Ippolz/SiliconSpike/README.md

# Silicon Spike, an Arduino Trigger Box for TMS

## Description
The Arduino Trigger Box project, developed at the Center for Cognitive Neuroscience of Cesena (University of Bologna), offers a reliable and efficient solution for triggering Transcranial Magnetic Stimulation (TMS) and Biopac systems. Designed by Giuseppe Ippolito and Thomas Quettier, this open-source initiative aims to provide the scientific community with a cost-effective and customizable trigger box solution.

## Features
- Easy integration with TMS and Biopac systems.
- Customizable triggering sequences.
- Open-source code for community collaboration and improvement.
- Detailed setup and usage instructions.

## Citing Our Work 
If you use our Arduino Trigger Box in your research, we kindly ask you to acknowledge our work. Please cite the following paper:

Ippolito, G., Quettier, T., Borgomaneri, S., & Romei, V. (2025). Silicon Spike: An Arduino-based low-cost and open-access triggerbox to precisely control TMS devices. _Behavior Research Methods_, _57_(5), 145. https://doi.org/10.3758/s13428-025-02653-y

## License
This project is licensed under the [SPECIFY LICENSE TYPE - e.g., MIT, GPL, Apache, etc.]. For more details, see the `LICENSE.md` file.

## Contact
For inquiries, please contact:
- Thomas Quettier - thomas.quettier2@unibo.it
- Giuseppe Ippolito - giuseppe.ippolito8@unibo.it

## Acknowledgements
We thank the Center for Cognitive Neuroscience, University of Bologna, for supporting this project.

## Collaborative Contributions
We welcome contributions from the community. Please read our `CONTRIBUTING.md` file for guidelines on how to submit improvements or report issues.

For collaborators contributing to this repository, please prefix your commit messages with appropriate tags for efficient tracking and management:
- **BF**: Bug Fix - for resolving errors or issues in existing code.
- **FF**: Feature Fix - for fixes to unreleased code features.
- **RF**: Refactoring - for code structure or design modifications.
- **NF**: New Feature - for introducing new functionalities.
- **ENH**: Enhancement - for improvements to existing features or code.
- **DOC**: Documentation - for updates or additions to project documentation.
- **TEST**: Testing - for adding new tests or modifying existing ones. 

Your cooperation and adherence to these guidelines help maintain the quality and integrity of our project. Thank you for your contributions to the IMPLICIT research initiative.
