Ippolz/SiliconSpike/Codes/Main Code/SiliconSpike_MainCode/SiliconSpike_MainCode.ino

// Triggerbox developed by Giuseppe Ippolito and Thomas Quettier
// Original article here: https://doi.org/10.3758/s13428-025-02653-y

#define MAX_COMMAND_LENGTH 64  // Maximum length of a command

// Pins setting
int LedPin = 3;
int BNC1 = 9, BNC2 = 8, MrkPin = 7;

// Variables setting
int TriggerDuration = 2000;
int IPI1 = 2000, IPI2 = 2000, IPI3 = 2000, IPI4 = 2000, IPI5 = 2000, IPI6 = 2000, IPI7 = 2000, IPI8 = 2000, IPI9 = 2000, IPI10 = 2000;
int nPuls1 = 5, nPuls2 = 5, nPuls3 = 5, nPuls4 = 5, nPuls5 = 5, nPuls6 = 5, nPuls7 = 5, nPuls8 = 5, nPuls9 = 5, nPuls10 = 5;
int MarkerDuration1 = 2000, MarkerDuration2 = 2000, MarkerDuration3 = 2000, MarkerDuration4 = 2000, MarkerDuration5 = 2000, MarkerDuration6 = 2000, MarkerDuration7 = 2000, MarkerDuration8 = 2000, MarkerDuration9 = 2000;
int test = 0, psw = 0;

char inputBuffer[MAX_COMMAND_LENGTH];  // Buffer to store incoming characters
int bufferIndex = 0;                   // Index to track the position in the buffer

void setup() {
  pinMode(LedPin, OUTPUT);  // Debug LED
  pinMode(BNC1, OUTPUT);    // Initialize BNC1 (or CS)
  pinMode(BNC2, OUTPUT);    // Initialize BNC2 (or TS)
  pinMode(MrkPin, OUTPUT);  // Initialize the markers BNC
  Serial.begin(115200);
  Serial.setTimeout(5);  // Set a timeout for the Serial Monitor (for faster code execution)
}


void loop() {
  digitalWrite(LedPin, HIGH);


  while (Serial.available() > 0 && bufferIndex < MAX_COMMAND_LENGTH - 1) {
    char incomingChar = Serial.read();

    // Check for the end of the command
    if (incomingChar == '.') {
      inputBuffer[bufferIndex] = '\0';      // Null-terminate the string
      processCommand(String(inputBuffer));  // Convert to String before calling
      bufferIndex = 0;                      // Reset the buffer index for the next command
    } else {
      inputBuffer[bufferIndex++] = incomingChar;  // Add the character to the buffer
    }
  }

  String command = Serial.readStringUntil('\n');

  if (command.length() > 0) {
    processCommand(command);
  }
}

void processCommand(String command) {

  if (command.equals("Triggerbox developed by Giuseppe Ippolito: https://doi.org/10.3758/s13428-025-02653-y")) {
    psw = 1;
  }
  if (psw == 1) {
    if (command.startsWith("SET,IPI1,")) {
      // Extract the number after "SET,IPI," and convert to integer
      IPI1 = command.substring(9).toInt();
      IPI1 = IPI1 * 1000;
      IPI1 = IPI1 - TriggerDuration;
    } else if (command.startsWith("SET,IPI2,")) {
      IPI2 = command.substring(9).toInt();
      IPI2 = IPI2 * 1000;
      IPI2 = IPI2 - TriggerDuration;
    } else if (command.startsWith("SET,IPI3,")) {
      IPI3 = command.substring(9).toInt();
      IPI3 = IPI3 * 1000;
      IPI3 = IPI3 - TriggerDuration;
    } else if (command.startsWith("SET,IPI4,")) {
      IPI4 = command.substring(9).toInt();
      IPI4 = IPI4 * 1000;
      IPI4 = IPI4 - TriggerDuration;
    } else if (command.startsWith("SET,IPI5,")) {
      IPI5 = command.substring(9).toInt();
      IPI5 = IPI5 * 1000;
      IPI5 = IPI5 - TriggerDuration;
    } else if (command.startsWith("SET,IPI6,")) {
      IPI6 = command.substring(9).toInt();
      IPI6 = IPI6 * 1000;
      IPI6 = IPI6 - TriggerDuration;
    } else if (command.startsWith("SET,IPI7,")) {
      IPI7 = command.substring(9).toInt();
      IPI7 = IPI7 * 1000;
      IPI7 = IPI7 - TriggerDuration;
    } else if (command.startsWith("SET,IPI8,")) {
      IPI8 = command.substring(9).toInt();
      IPI8 = IPI8 * 1000;
      IPI8 = IPI8 - TriggerDuration;
    } else if (command.startsWith("SET,IPI9,")) {
      IPI9 = command.substring(9).toInt();
      IPI9 = IPI9 * 1000;
      IPI9 = IPI9 - TriggerDuration;
      // Set number of pulses for rTMS
    } else if (command.startsWith("SET,nPULS1,")) {
      nPuls1 = command.substring(11).toInt();
    } else if (command.startsWith("SET,nPULS2,")) {
      nPuls2 = command.substring(11).toInt();
    } else if (command.startsWith("SET,nPULS3,")) {
      nPuls3 = command.substring(11).toInt();
    } else if (command.startsWith("SET,nPULS4,")) {
      nPuls4 = command.substring(11).toInt();
    } else if (command.startsWith("SET,nPULS5,")) {
      nPuls5 = command.substring(11).toInt();
    } else if (command.startsWith("SET,nPULS6,")) {
      nPuls6 = command.substring(11).toInt();
    } else if (command.startsWith("SET,nPULS7,")) {
      nPuls7 = command.substring(11).toInt();
    } else if (command.startsWith("SET,nPULS8,")) {
      nPuls8 = command.substring(11).toInt();
    } else if (command.startsWith("SET,nPULS9,")) {
      nPuls9 = command.substring(11).toInt();
      // Set Marker duration
    } else if (command.startsWith("SET,MRK1,")) {
      MarkerDuration1 = command.substring(9).toInt();
      MarkerDuration1 = MarkerDuration1 * 1000;
    } else if (command.startsWith("SET,MRK2,")) {
      MarkerDuration2 = command.substring(9).toInt();
      MarkerDuration2 = MarkerDuration2 * 1000;
    } else if (command.startsWith("SET,MRK3,")) {
      MarkerDuration3 = command.substring(9).toInt();
      MarkerDuration3 = MarkerDuration3 * 1000;
    } else if (command.startsWith("SET,MRK4,")) {
      MarkerDuration4 = command.substring(9).toInt();
      MarkerDuration4 = MarkerDuration4 * 1000;
    } else if (command.startsWith("SET,MRK5,")) {
      MarkerDuration5 = command.substring(9).toInt();
      MarkerDuration5 = MarkerDuration5 * 1000;
    } else if (command.startsWith("SET,MRK6,")) {
      MarkerDuration6 = command.substring(9).toInt();
      MarkerDuration6 = MarkerDuration6 * 1000;
    } else if (command.startsWith("SET,MRK7,")) {
      MarkerDuration7 = command.substring(9).toInt();
      MarkerDuration7 = MarkerDuration7 * 1000;
    } else if (command.startsWith("SET,MRK8,")) {
      MarkerDuration8 = command.substring(9).toInt();
      MarkerDuration8 = MarkerDuration8 * 1000;
    } else if (command.startsWith("SET,MRK9,")) {
      MarkerDuration9 = command.substring(9).toInt();
      MarkerDuration9 = MarkerDuration9 * 1000;
    } 

    String condstr = Serial.readStringUntil('\n');
    condstr.trim();

    if (command.startsWith("dcTMS")) {
      while (true) {
        if (Serial.available() > 0) {
          char val = Serial.read();
          if (val == '1') {
            digitalWrite(BNC1, HIGH);
            digitalWrite(MrkPin, HIGH);
            unsigned long startTime = micros(); 
            while (micros() - startTime < TriggerDuration) {
            }
            digitalWrite(BNC1, LOW);
            digitalWrite(MrkPin, LOW);
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
            digitalWrite(MrkPin, LOW);
          } else if (val == 'I') {
            digitalWrite(MrkPin, HIGH);
            unsigned long startTime = micros();
            while (micros() - startTime < MarkerDuration9) {
            }
            digitalWrite(MrkPin, LOW);
          }

          else if (val == 'Z') {
            TriggerDuration = 2000;
            psw = 0;
            return;
          }
        }
      }
    } else if (command.startsWith("spTMS")) {
      while (true) {
        if (Serial.available() > 0) {
          char val = Serial.read();
          if (val == '1') {
            digitalWrite(BNC1, HIGH);
            unsigned long startTime = micros();  // Starting time
            while (micros() - startTime < TriggerDuration) {
            }
            digitalWrite(BNC1, LOW);
          } else if (val == '2') {
            digitalWrite(BNC2, HIGH);
            unsigned long startTime = micros();  // Starting time
            while (micros() - startTime < TriggerDuration) {
            }
            digitalWrite(BNC2, LOW);
          } else if (val == '3') {
            digitalWrite(MrkPin, HIGH);
            unsigned long startTime = micros();  // Starting time
            while (micros() - startTime < TriggerDuration) {
            }
            digitalWrite(MrkPin, LOW);

          } else if (val == 'A') {
            digitalWrite(MrkPin, HIGH);
            unsigned long startTime = micros();
            while (micros() - startTime < MarkerDuration1) {
            }
            digitalWrite(MrkPin, LOW);
          } else if (val == 'B') {
            digitalWrite(MrkPin, HIGH);
            unsigned long startTime = micros();
            while (micros() - startTime < MarkerDuration2) {
            }
            digitalWrite(MrkPin, LOW);
          } else if (val == 'C') {
            digitalWrite(MrkPin, HIGH);
            unsigned long startTime = micros();
            while (micros() - startTime < MarkerDuration3) {
            }
            digitalWrite(MrkPin, LOW);
          } else if (val == 'D') {
            digitalWrite(MrkPin, HIGH);
            unsigned long startTime = micros();
            while (micros() - startTime < MarkerDuration4) {
            }
            digitalWrite(MrkPin, LOW);
          } else if (val == 'E') {
            digitalWrite(MrkPin, HIGH);
            unsigned long startTime = micros();
            while (micros() - startTime < MarkerDuration5) {
            }
            digitalWrite(MrkPin, LOW);
          } else if (val == 'F') {
            digitalWrite(MrkPin, HIGH);
            unsigned long startTime = micros();
            while (micros() - startTime < MarkerDuration6) {
            }
            digitalWrite(MrkPin, LOW);
          } else if (val == 'G') {
            digitalWrite(MrkPin, HIGH);
            unsigned long startTime = micros();
            while (micros() - startTime < MarkerDuration7) {
            }
            digitalWrite(MrkPin, LOW);
          } else if (val == 'H') {
            digitalWrite(MrkPin, HIGH);
            unsigned long startTime = micros();
            while (micros() - startTime < MarkerDuration8) {
            }
            digitalWrite(MrkPin, LOW);
          } else if (val == 'I') {
            digitalWrite(MrkPin, HIGH);
            unsigned long startTime = micros();
            while (micros() - startTime < MarkerDuration9) {
            }
            digitalWrite(MrkPin, LOW);
          }

          else if (val == 'Z') {
            TriggerDuration = 2000;
            psw = 0;
            return;
          }
        }
      }
    }
  }
}
